ngoquytuan/PAPI/Hardware/BanVePAPI72018/PAPI - DK - 03.pdf

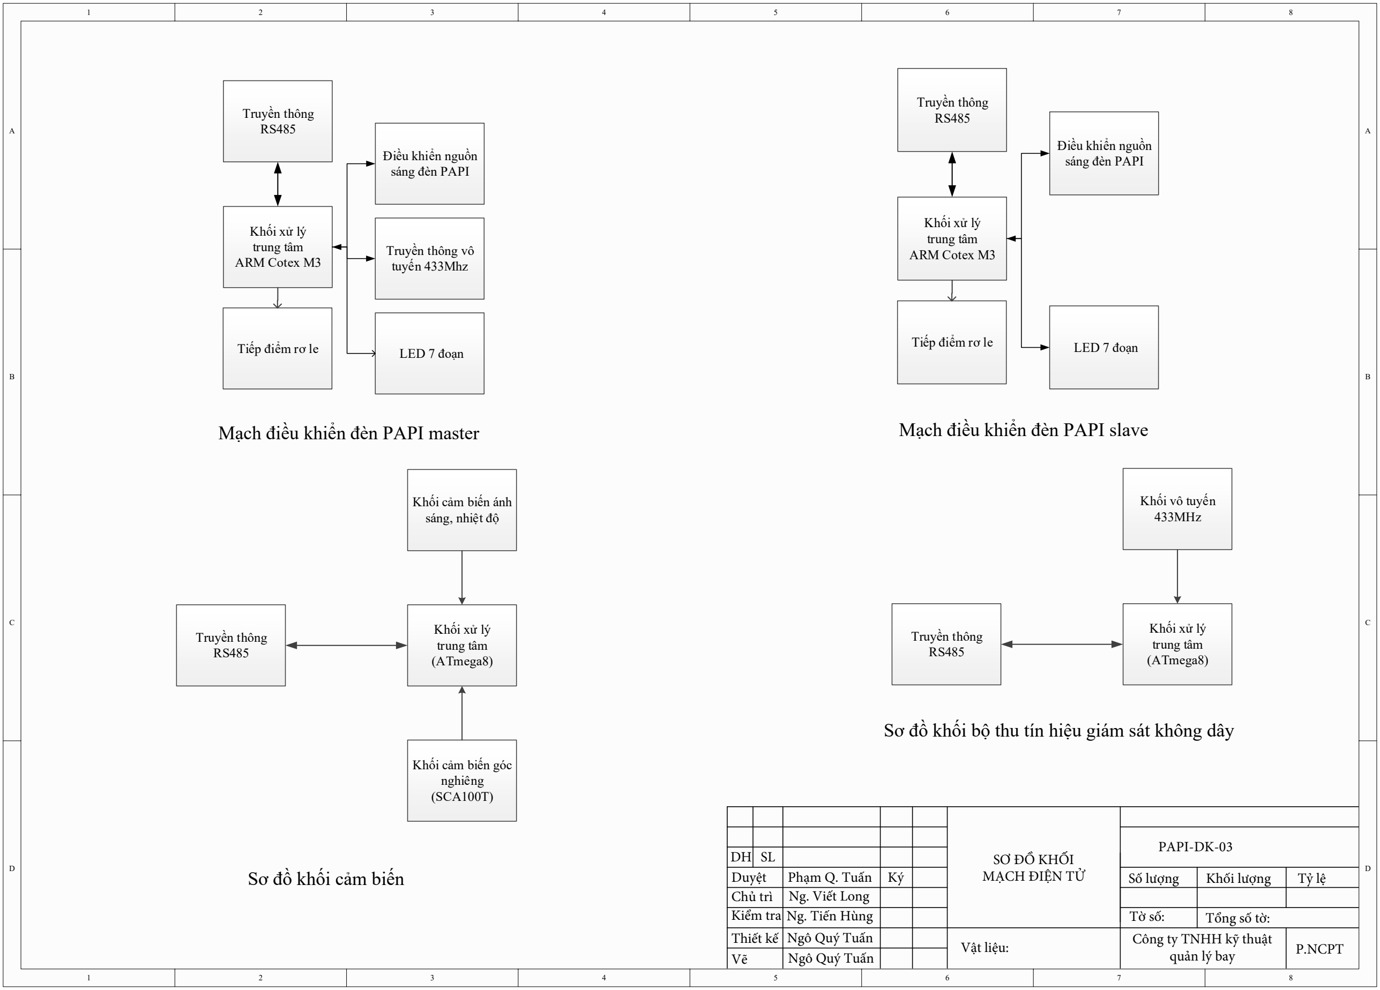
[picture p1: figure]
SƠ ĐỒ KHỐI MẠCH ĐIỆN TỬ; Chủ trì; Ng. Viết Long; Ngô Quý Tuấn; PAPI-DK-03; Khối xử lý trung tâm (ATmega8); Khối vô tuyến 433MHz; Truyền thông RS485; Khối xử lý trung tâm ARM Cotex M3; Tiếp điểm rơ le; Điều khiển nguồn sáng đèn PAPI; LED 7 đoạn; Truyền thông vô tuyến 433Mhz; Khối cảm biến ánh sáng, nhiệt độ; Khối cảm biến góc nghiêng (SCA100T); Sơ đồ khối cảm biến

Duyệt | Phạm Q. Tuấn | Ký | | Số lượng | Khối lượng | Tỷ lệ
Kiểm tra | Ng. Tiến Hùng | | | Tờ số: | Tổng số tờ:
Thiết kế | Ngô Quý Tuấn | | Vật liệu: | Công ty TNHH kỹ thuật quản lý bay | | P.NCPT

# Sơ đồ khối bộ thu tín hiệu giám sát không dây

Mạch điều khiển đèn PAPI master | Mạch điều khiển đèn PAPI slave
