ngoquytuan/PAPI/Hardware/BanVePAPI72018/PAPI - DK - 02.pdf

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
D | D
B | B
C | C
A | A

SƠ ĐỒ KHỐI ĐÈN PAPI

DH | SL
Duyệt | Phạm Q. Tuấn | Ký | | Số lượng | Khối lượng | Tỷ lệ
Chủ trì | Ng. Viết Long
Kiểm tra | Ng. Tiến Hùng | | | Tờ số: | Tổng số tờ:
Thiết kế | Ngô Quý Tuấn | | Vật liệu: | Công ty TNHH kỹ thuật quản lý bay | | P.NCPT
Vẽ | Ngô Quý Tuấn

PAPI-DK-02

Khối điều khiển

Khối cảm biến

Khối nguồn | 24VDC/15W

RS485

Khối lực

Khối truyền thông
RF433MHz, RS485

Khối điều khiển

Khối cảm biến

Khối nguồn | 24VDC/15W

RS485

Khối lực

Khối truyền thông
RS485
Sơ đồ khối đèn PAPI master | Sơ đồ khối đèn PAPI slave
