ngoquytuan/PAPI/Hardware/BanVePAPI72018/PAPI - DK - 10.pdf

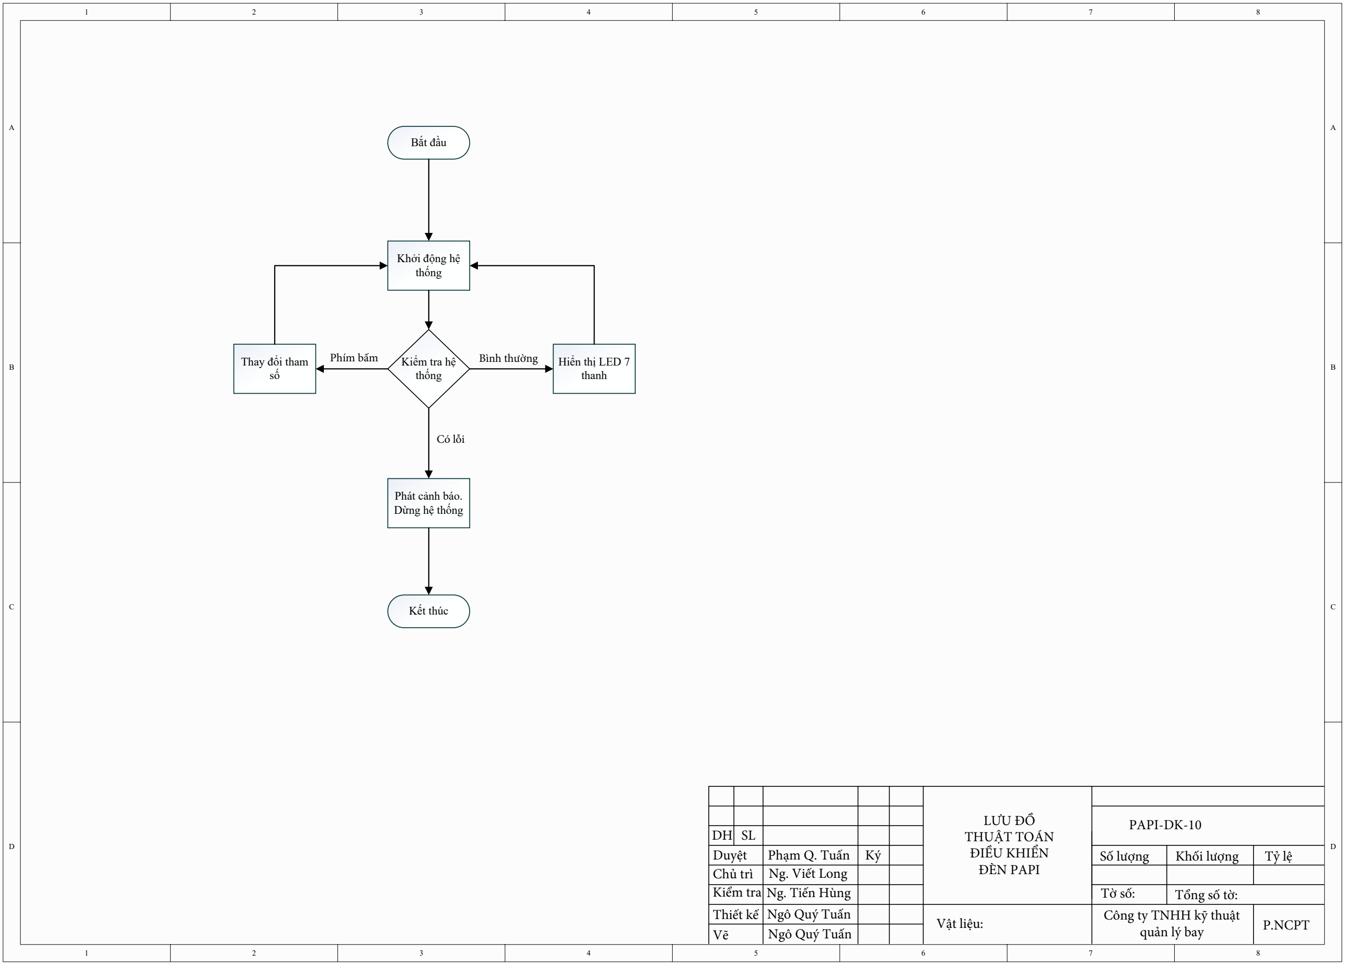
[picture p2: figure]
PAPI-DK-10; Duyệt; Phạm Q. Tuấn; Số lượng; Khối lượng; Kiểm tra; Ng. Tiến Hùng; Tổng số tờ:; Chủ trì; Ng. Viết Long; Ngô Quý Tuấn; Bắt đầu; Kết thúc; Phát cảnh báo. Dừng hệ thống; Thay đổi tham số; Hiển thị LED 7 thanh; Khởi động hệ thống; Kiểm tra hệ thống; Phím bấm; Bình thường; Có lỗi

LƯU ĐỒ THUẬT TOÁN ĐIỀU KHIỂN ĐÈN PAPI

Thiết kế | Ngô Quý Tuấn | | Vật liệu: | Công ty TNHH kỹ thuật quản lý bay | | P.NCPT
