ngoquytuan/PAPI/Hardware/BanVePAPI72018/PAPI - DK - 05_FIX.pdf

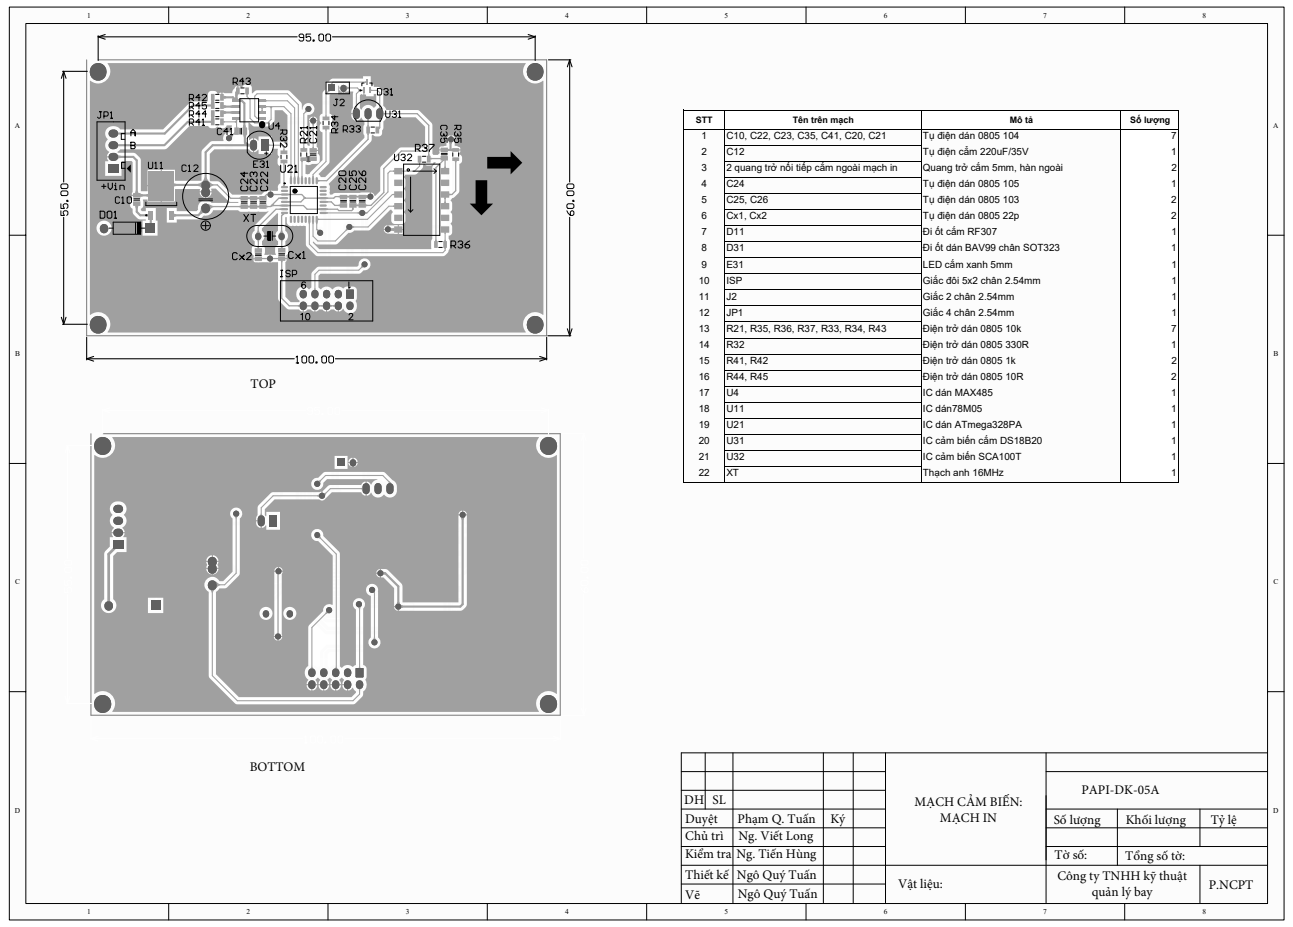
[picture p3: page 1]

Tụ điện dán 0805 104
Tụ điện cẳm 220uF/35V
Tụ điện dán 0805 105
Tụ điện dán 0805 103
Đi ốt cắm RF307
Đi ốt dán BAV99 chân SOT323
LED cắm xanh 5mm
Giắc đôi 5x2 chân 2.54mm
Giắc 2 chân 2.54mm
Giắc 4 chân 2.54mm
Điện trở dán 0805 10k
Điện trở dán 0805 330R
Điện trở dán 0805 1k
Điện trở dán 0805 10R
IC dán MAX485
IC dán78M05
IC dán ATmega328PA
IC cảm biến cắm DS18B20
IC cảm biến SCA100T

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

MẠCH CẢM BIẾN: MẠCH IN
