ngoquytuan/PAPI/Hardware/BanVePAPI72018/PAPI - DK - 07_FIX.pdf

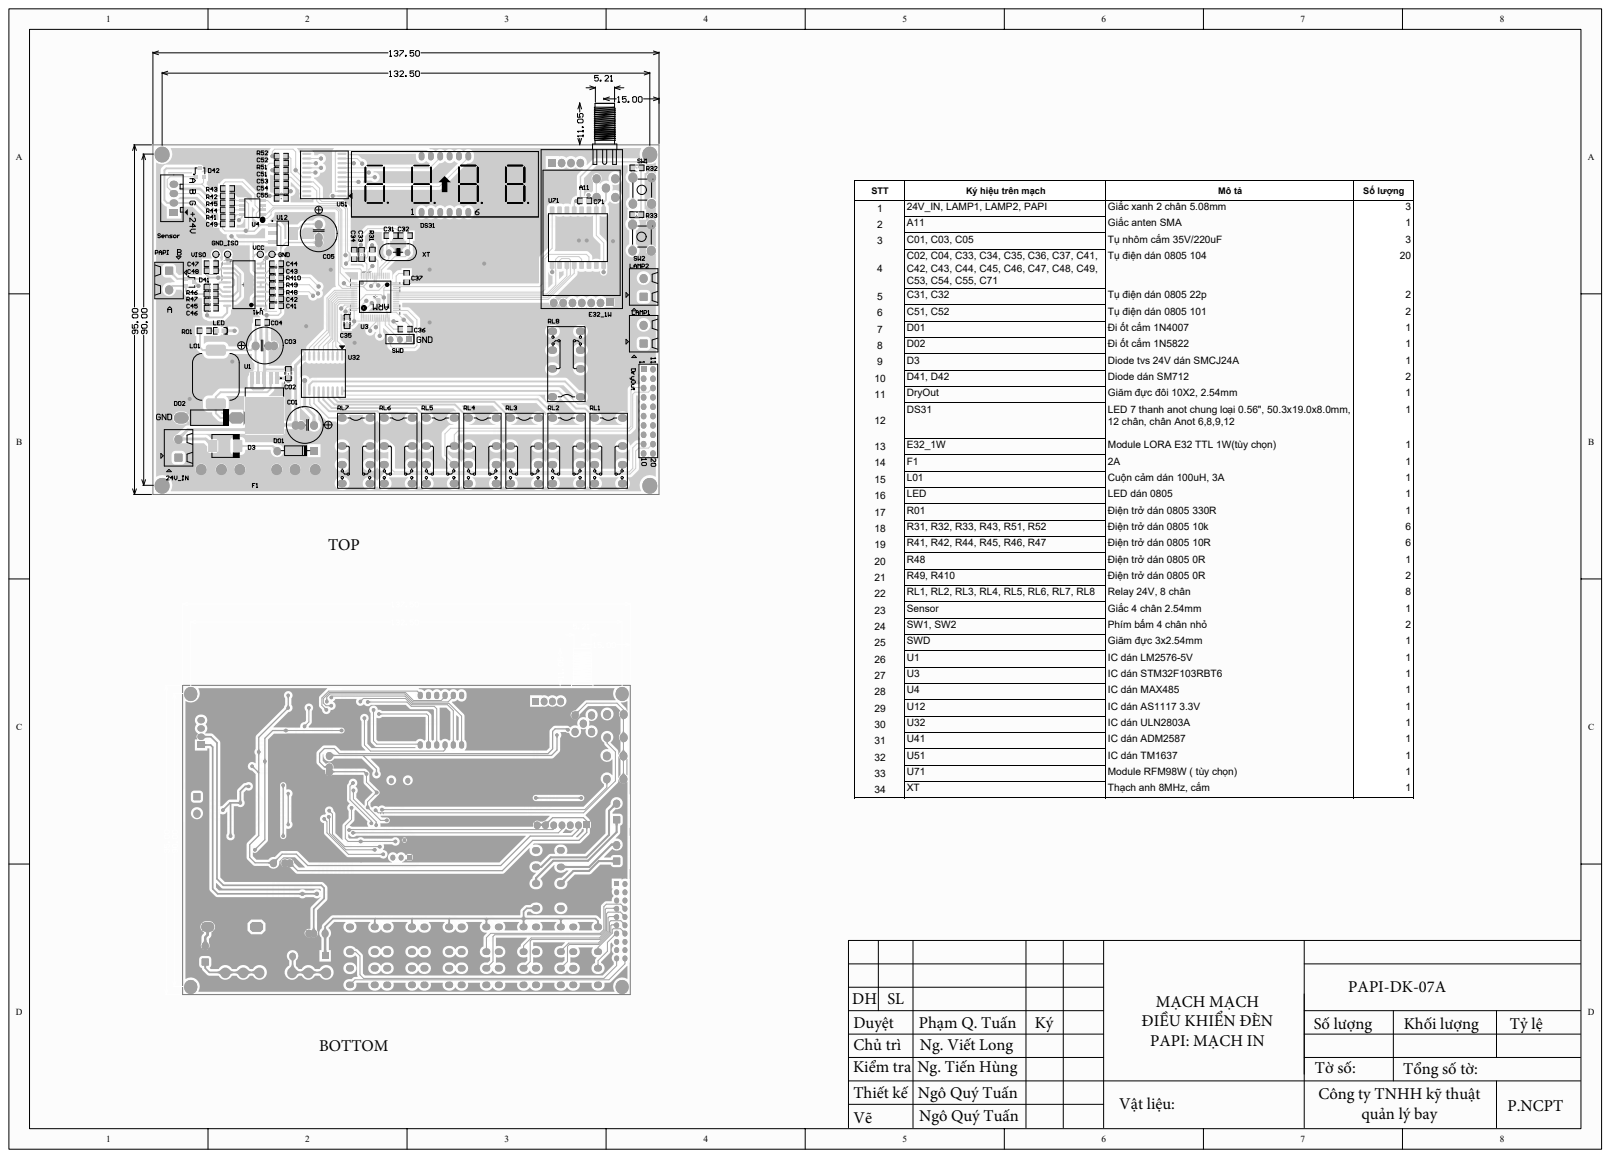
[picture p4: page 1]

Tụ điện dán 0805 22p
Tụ điện dán 0805 101
Đi ốt cắm 1N4007
Đi ốt cắm 1N5822
Diode tvs 24V dán SMCJ24A
Diode dán SM712
Giăm đực đôi 10X2, 2.54mm
LED 7 thanh anot chung loại 0.56", 50.3x19.0x8.0mm,
12 chân, chân Anot 6,8,9,12

Module LORA E32 TTL 1W(tùy chọn)
Cuộn cảm dán 100uH, 3A
LED dán 0805
Điện trở dán 0805 330R
Điện trở dán 0805 10k
Điện trở dán 0805 10R
Điện trở dán 0805 0R
Relay 24V, 8 chân
Giắc 4 chân 2.54mm
Phím bấm 4 chân nhỏ
Giăm đực 3x2.54mm
IC dán LM2576-5V
IC dán STM32F103RBT6
IC dán MAX485
IC dán AS1117 3.3V
IC dán ULN2803A
IC dán ADM2587
IC dán TM1637
Module RFM98W ( tùy chọn)

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

MẠCH MẠCH ĐIỀU KHIỂN ĐÈN PAPI: MẠCH IN
