ngoquytuan/PAPI/Hardware/BanVePAPI72018/PAPI - DK - 09_FIX.pdf

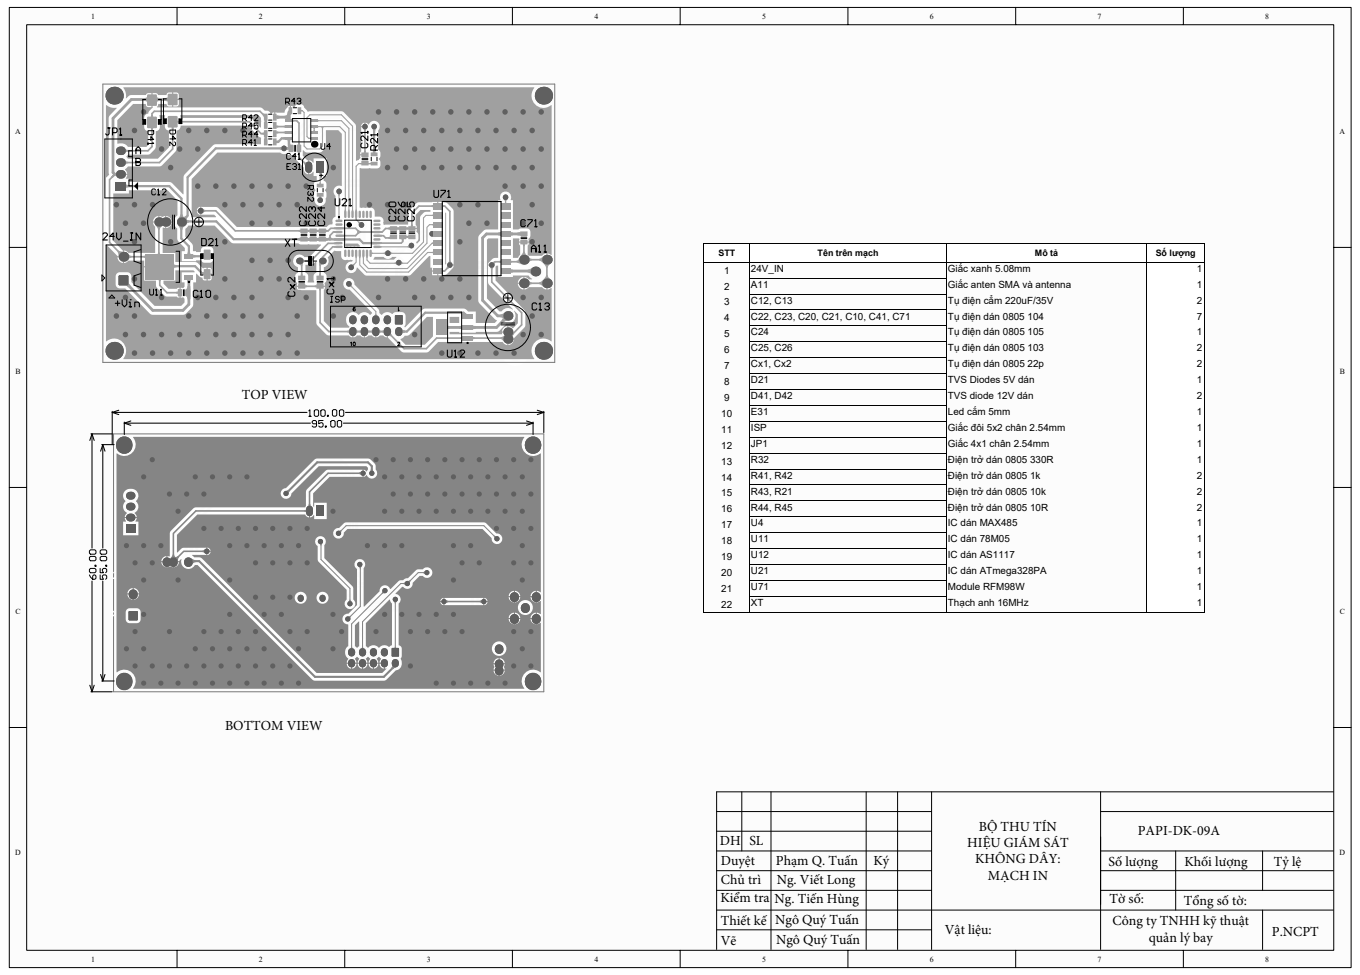
[picture p5: page 1]

Giắc xanh 5.08mm
Giắc anten SMA và antenna
Tụ điện dán 0805 104
Tụ điện dán 0805 105
Tụ điện dán 0805 103
TVS Diodes 5V dán
TVS diode 12V dán
Led cắm 5mm
Giắc đôi 5x2 chân 2.54mm
Giắc 4x1 chân 2.54mm
Điện trở dán 0805 330R
Điện trở dán 0805 1k
Điện trở dán 0805 10k
Điện trở dán 0805 10R
IC dán MAX485
IC dán 78M05
IC dán AS1117
IC dán ATmega328PA
Module RFM98W

BỘ THU TÍN HIỆU GIÁM SÁT KHÔNG DÂY: MẠCH IN

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
