ngoquytuan/PAPI/Hardware/BanVePAPI72018/PAPI - DK - 11_FIX.pdf

Cảm biến quang 1 và 2 mắc nối tiếp, các cảm biến quan được lắp đảm bảo hứng sáng của các đèn!

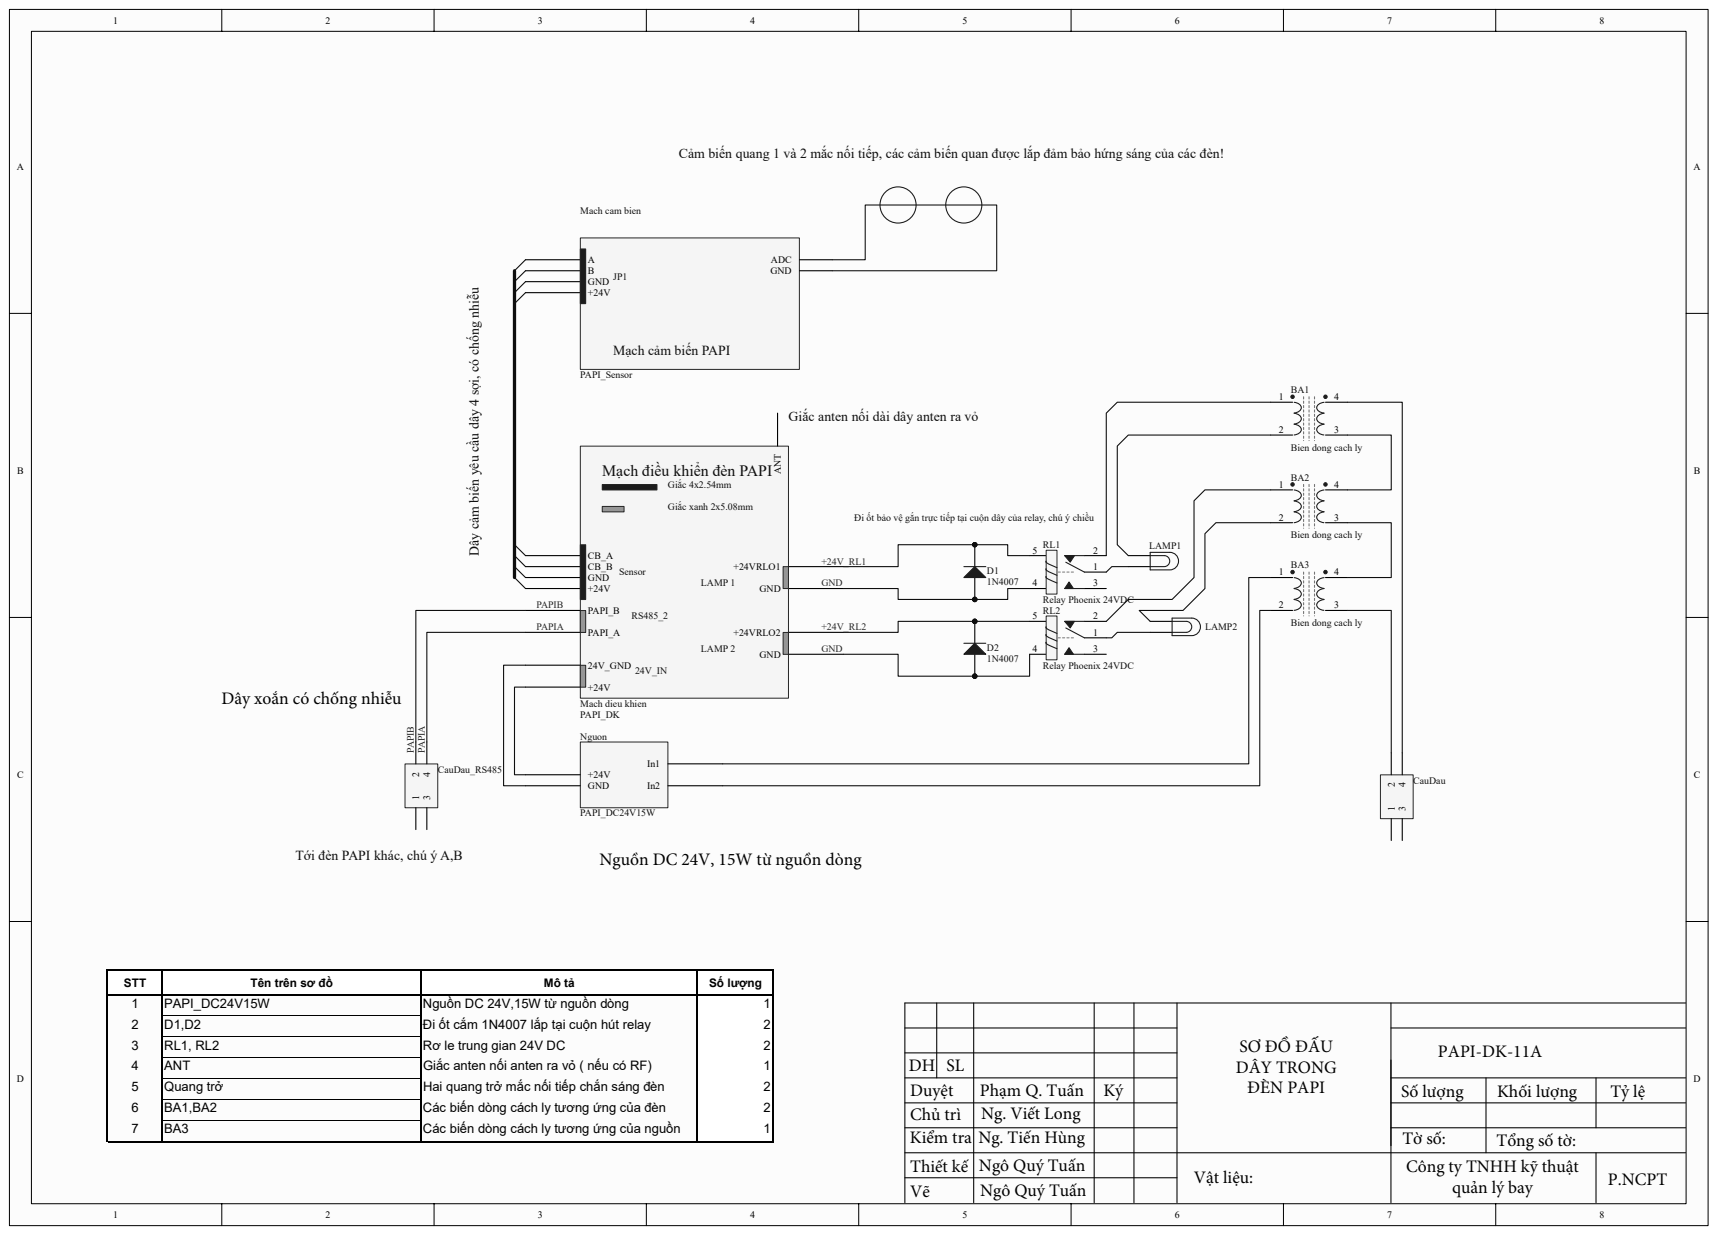
[picture p6: page 1]
PAPI-DK-11A; Số lượng; Khối lượng; Duyệt; Phạm Q. Tuấn; Chủ trì; 3 Relay Phoenix 24VDC; LAMP1; LAMP2; 4CauDau; 4CauDau_RS485 In1; +24V GND; Nguon; 24V_GND; PAPI_A; PAPI_B; GND; +24VRLO1; +24VRLO2; Sensor; LAMP 1; LAMP 2; Giắc 4x2.54mm; Giắc xanh 2x5.08mm; ANT; Mach dieu khien PAPI_DK; A B GND +24V; ADC GND; PAPI_Sensor; PAPIA; PAPIB; STT; Tên trên sơ đồ; PAPI_DC24V15W; Quang trở; Các biến dòng cách ly tương ứng của nguồn

Mach cam bien

Dây cảm biến yêu cầu dây 4 sợi, có chống nhiễu Giắc anten nối dài dây anten ra vỏ

Mạch cảm biến PAPI

Bien dong cach ly

Mạch điều khiển đèn PAPI

Đi ốt bảo vệ gắn trực tiếp tại cuộn dây của relay, chú ý chiều

Dây xoắn có chống nhiễu

PAPI_DC24V15W
Nguồn DC 24V, 15W từ nguồn dòng

Tới đèn PAPI khác, chú ý A,B

Nguồn DC 24V,15W từ nguồn dòng
Đi ốt cắm 1N4007 lắp tại cuộn hút relay
Rơ le trung gian 24V DC
Giắc anten nối anten ra vỏ ( nếu có RF)
Hai quang trở mắc nối tiếp chắn sáng đèn
Các biến dòng cách ly tương ứng của đèn

SƠ ĐỒ ĐẤU DÂY TRONG ĐÈN PAPI

Ng. Viết Long

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
