ngoquytuan/PAPI/Hardware/BanVePAPI72018/PAPI - DK - 08.pdf

# Truyền thông RS485

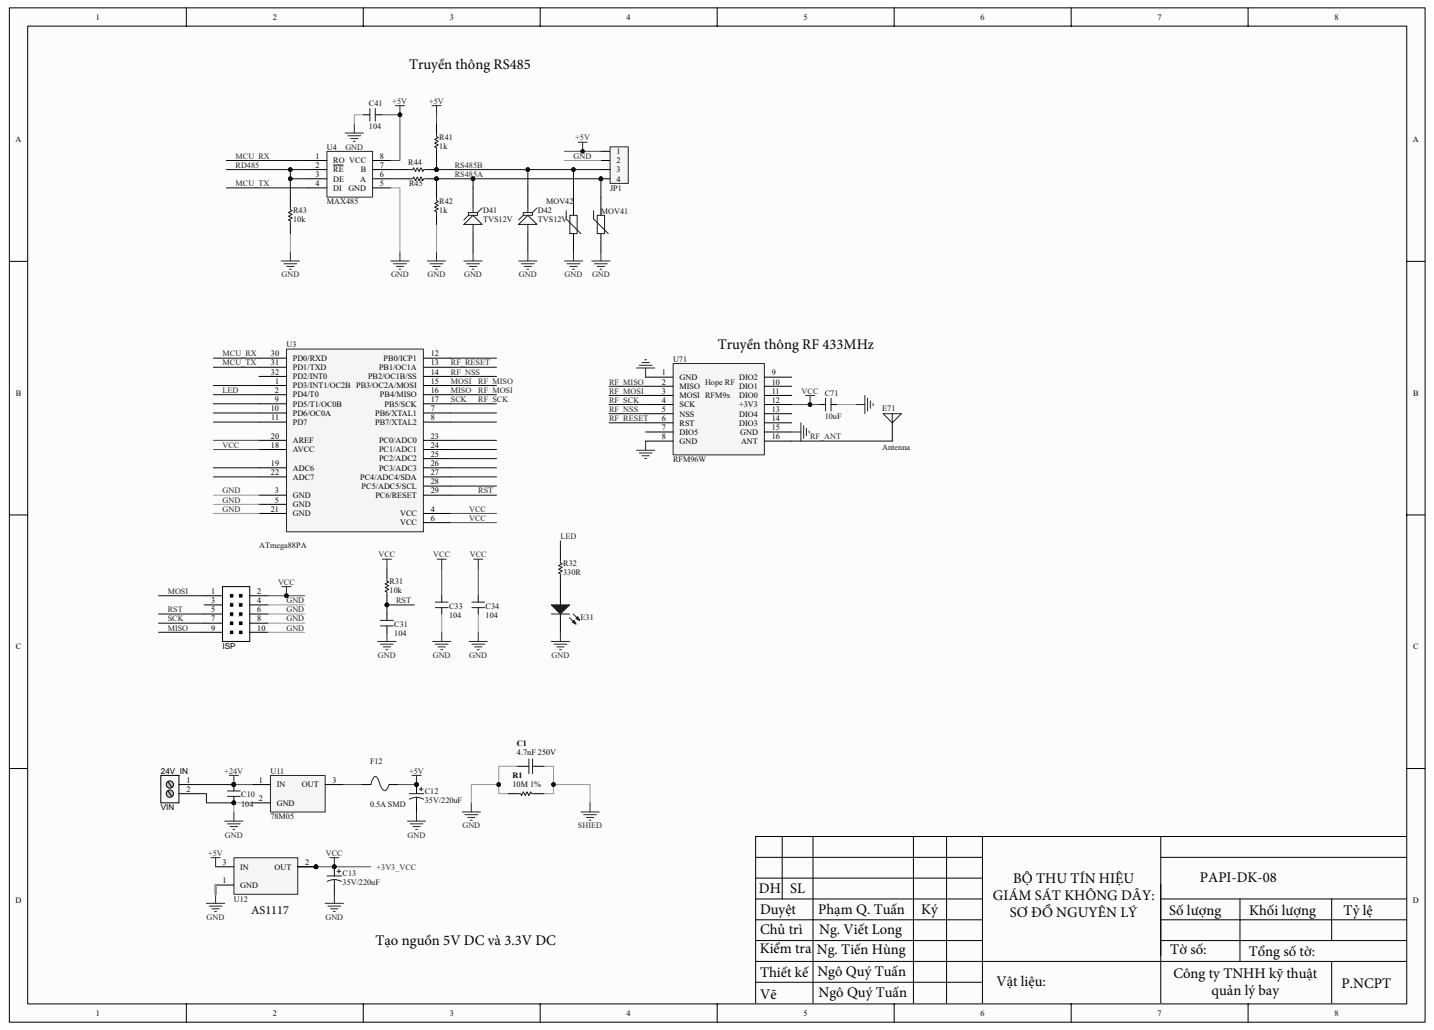
[picture p7: page 1]

BỘ THU TÍN HIỆU GIÁM SÁT KHÔNG DÂY: SƠ ĐỒ NGUYÊN LÝ

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

GND
Tạo nguồn 5V DC và 3.3V DC
