ngoquytuan/PAPI/Hardware/BanVePAPI72018/PAPI - DK - 01.pdf

## Điều dòng

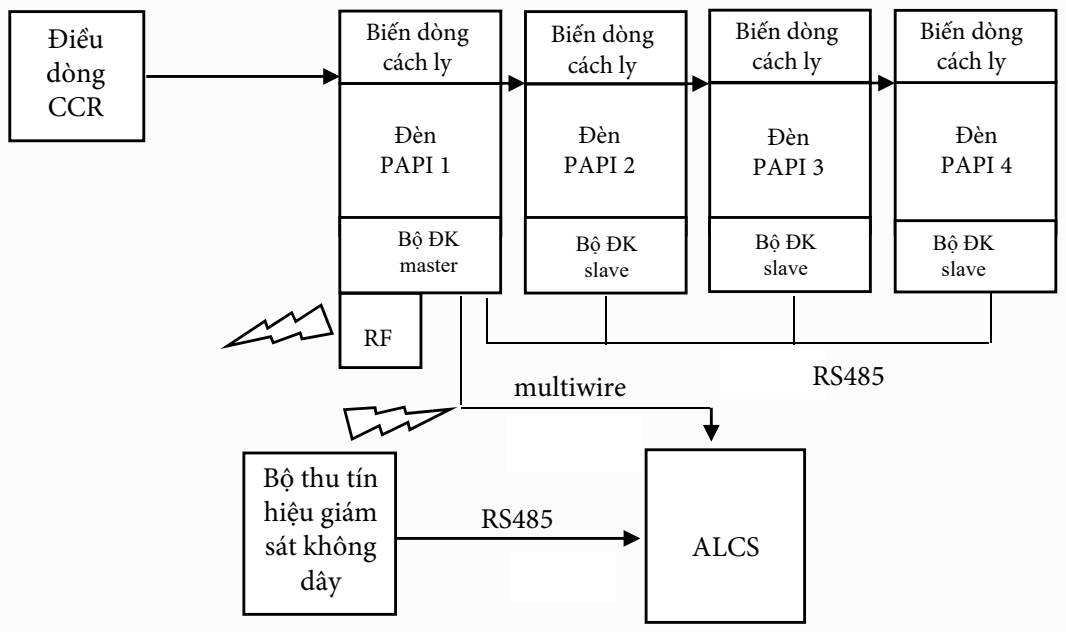
[picture p8: page 1]
PAPI-DK-01; Bộ ĐK master; ALCS; multiwire; CCR; Biến dòng cách ly; Đèn PAPI 1; Đèn PAPI 2; Đèn PAPI 3; Đèn PAPI 4; Bộ ĐK slave

Bộ thu tín
hiệu giám
sát không
dây

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

SƠ ĐỒ KHỐI HỆ THỐNG ĐÈN PAPI
