ngoquytuan/PAPI/(list of files, drawings)

Other design files:
Hardware/PAPI_M1_Sensor/PAPI_M1_Sensor.PcbDoc
Hardware/PAPI_M1_Sensor/PAPI_M1_Sensor.PrjPcb
Hardware/PAPI_M1_Sensor/PAPI_M1_Sensor.SchDoc
Hardware/PAPI_M2_Control/PAPI_M2_Control.PrjPcb
Hardware/PAPI_M2_Control/PAPI_M2_Control.SchDoc
Hardware/PAPI_M3_RF/PAPI_M3_RF.PcbDoc
Hardware/PAPI_M3_RF/PAPI_M3_RF.PrjPcb
Hardware/PAPI_M3_RF/PAPI_M3_RF.SchDoc
