ngoquytuan/PAPI/Firmware/M2Control/PAPI_STM32F103RB/Inc/tm1637.h

//  Author: avishorp@gmail.com
//
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
#ifndef __TM1637DISPLAY__
#define __TM1637DISPLAY__
#define SEG_A   0b00000001
#define SEG_B   0b00000010
#define SEG_C   0b00000100
#define SEG_D   0b00001000
#define SEG_E   0b00010000
#define SEG_F   0b00100000
#define SEG_G   0b01000000

#define TM1637_I2C_COMM1    0x40
#define TM1637_I2C_COMM2    0xC0
#define TM1637_I2C_COMM3    0x80
// Configuration.
#define CLK_PORT GPIOB
#define DIO_PORT GPIOB
#define CLK_PIN GPIO_PIN_12
#define DIO_PIN GPIO_PIN_13
#define CLK_PORT_CLK_ENABLE __HAL_RCC_GPIOB_CLK_ENABLE
#define DIO_PORT_CLK_ENABLE __HAL_RCC_GPIOB_CLK_ENABLE

void tm1637Init(void);
void tm1637DisplayDecimal(int v, int displaySeparator);
void tm1637SetBrightness(char brightness);
void TM1637_Disp_Dot(unsigned char seg1,unsigned char seg2,unsigned char seg3,unsigned char seg4);

#endif // __TM1637DISPLAY__
