ngoquytuan/PAPI/Firmware/M1Sensor/mega88_spi_115200/SimpleKalmanFilter.c

/* 
 * SimpleKalmanFilter - a Kalman Filter implementation for single variable models.
 * Created by Denys Sene, January, 1, 2017.
 * Released under MIT License - see LICENSE file for details.
 */
#include "SimpleKalmanFilter.h"
#include <math.h>
#include <stdlib.h>
//float u_kalman,u;
float _err_measure;
float _err_estimate;
float _q;
float _current_estimate;
float _last_estimate;
float _kalman_gain;
	
void SimpleKalmanFilter(float mea_e, float est_e, float q)
{
  _err_measure=mea_e;
  _err_estimate=est_e;
  _q = q;
}

float updateEstimate(float mea)
{
  _kalman_gain = _err_estimate/(_err_estimate + _err_measure);
  _current_estimate = _last_estimate + _kalman_gain * (mea - _last_estimate);
  _err_estimate =  (1.0 - _kalman_gain)*_err_estimate + fabs(_last_estimate-_current_estimate)*_q;
  _last_estimate=_current_estimate;

  return _current_estimate;
}
