ngoquytuan/PAPI/(commit log)

2018-06-29 Add hardware design docs
    [PAPI_M1_Sensor.PcbDoc, PAPI_M1_Sensor.PrjPcb, PAPI_M1_Sensor.SchDoc, PAPI_M2_Control.PrjPcb, PAPI_M2_Control.SchDoc, PAPI_M3_RF.PcbDoc, PAPI_M3_RF.PrjPcb, PAPI_M3_RF.SchDoc]
2018-06-29 Update information...
    Fix M1, BOM
    [PAPI_M1_Sensor.PrjPcb, PAPI_M1_Sensor.SchDoc, PAPI_M1_Sensor.xls, PAPI_M1_Sensor_TL.xls]
2018-07-05 Xong m2
    [PAPI_M1_Sensor.PcbDoc, PAPI_M1_Sensor.PrjPcb, PAPI_M1_Sensor.SchDoc, PAPI_M1_Sensor_TL.xls, PAPI_M2_Control.PrjPcb, PAPI_M2_Control.SchDoc, PAPI_M2_Control.xls]
2018-08-02 Add M1 sensor code
    Ok
    [PAPI_M1_Sensor.PcbDoc, PAPI_M1_Sensor.SchDoc, PAPI_M1_Sensor.xls, PAPI_M1_Sensor_TL.xls, PAPI_M2_Control.PrjPcb, PAPI_M2_Control.SchDoc, PAPI_M2_Control.xls, PAPI_M3_RF.PcbDoc]
2018-08-02 Code done
    PAPI sensor add full kalman
    PAPI master ok
