ngoquytuan/PAPI/(notices)

Notices in the files:
Firmware/M2Control/PAPI_STM32F103RB/Inc/main.h:
COPYRIGHT(c) 2017 STMicroelectronics
Firmware/M2Control/PAPI_STM32F103RB/Src/main.c:
(C) COPYRIGHT STMicroelectronics *****END OF FILE
